dpmcgarry/esp32-marine-sensorhub-v2/hardware/mshv2/mshv2.kicad_sch

## KiCad design hardware/mshv2/mshv2.kicad_sch (2025-12-29, an earlier design)

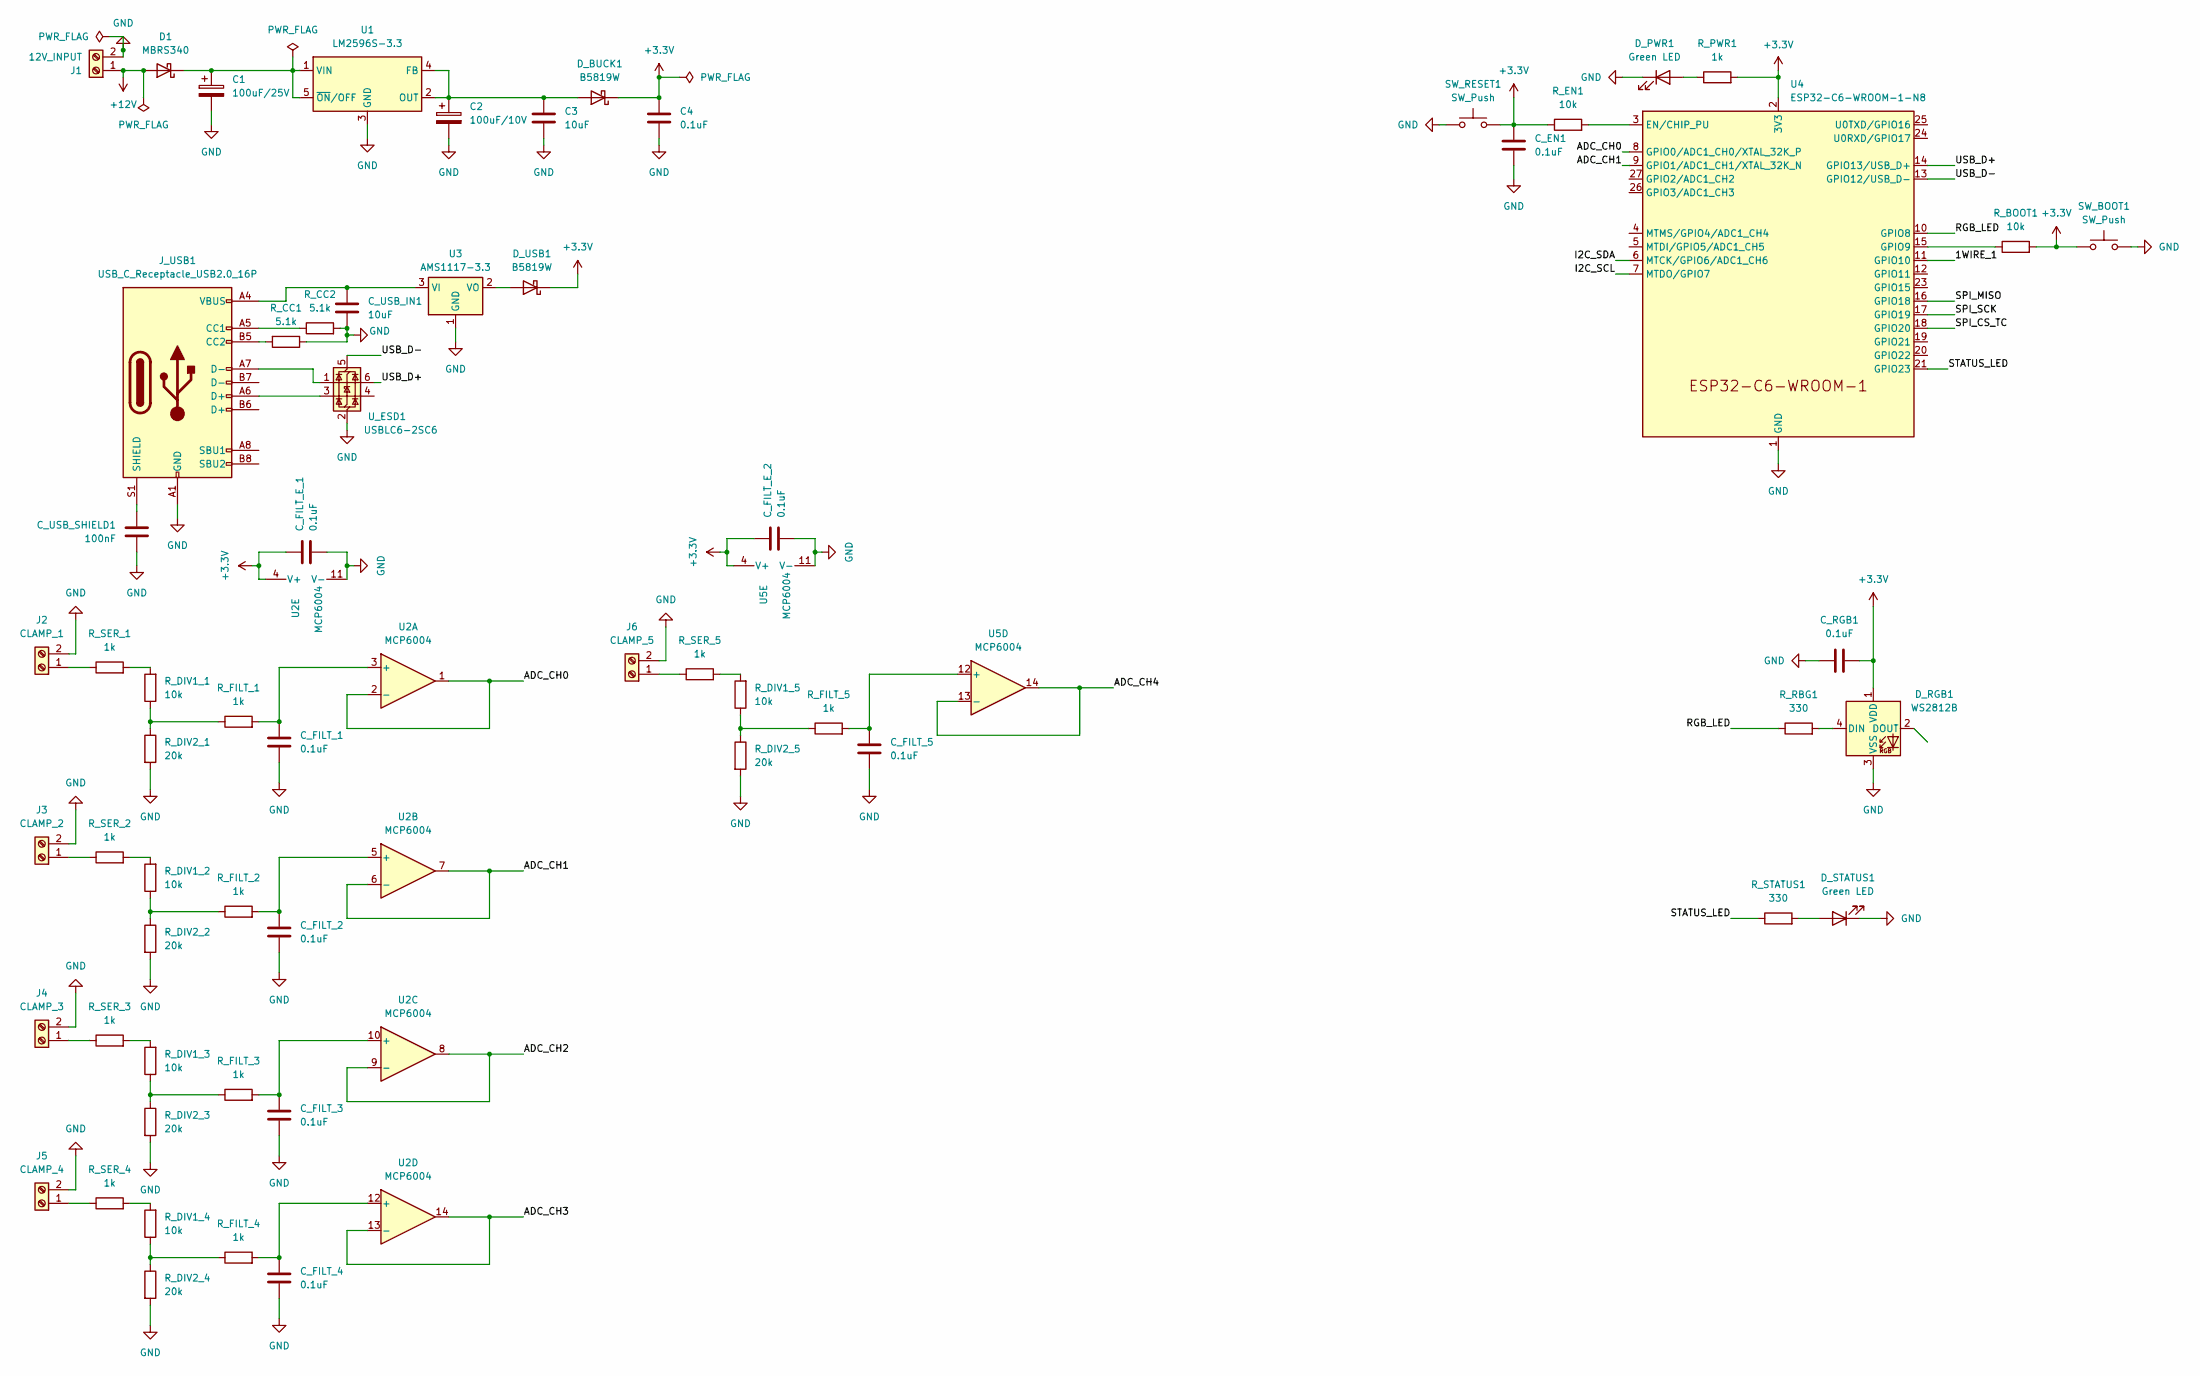
[picture p1: schematic mshv2.kicad_sch]

Parts:
C1: 100uF/25V; C_0201_0603Metric
C2: 100uF/10V; C_0201_0603Metric
C3: 10uF; C_0201_0603Metric
C4: 0.1uF; C_0201_0603Metric
C_EN1: 0.1uF; C_0201_0603Metric
C_FILT_1, C_FILT_2, C_FILT_3, C_FILT_4, C_FILT_5: 0.1uF; C_0201_0603Metric
C_FILT_E_1, C_FILT_E_2: 0.1uF; C_0201_0603Metric
C_RGB1: 0.1uF; C_0201_0603Metric
C_USB_IN1: 10uF; C_0201_0603Metric
C_USB_SHIELD1: 100nF; C_0201_0603Metric
D1: MBRS340; D_SMC
D_BUCK1: B5819W; D_0201_0603Metric
D_PWR1: Green LED; LED_0603_1608Metric
D_RGB1: WS2812B; LED_WS2812B_PLCC4_5.0x5.0mm_P3.2mm
D_STATUS1: Green LED; LED_0603_1608Metric
D_USB1: B5819W; D_0201_0603Metric
J1: 12V_INPUT; TerminalBlock_MaiXu_MX126-5.0-02P_1x02_P5.00mm
J2: CLAMP_1; TerminalBlock_MaiXu_MX126-5.0-02P_1x02_P5.00mm
J3: CLAMP_2; TerminalBlock_MaiXu_MX126-5.0-02P_1x02_P5.00mm
J4: CLAMP_3; TerminalBlock_MaiXu_MX126-5.0-02P_1x02_P5.00mm
J5: CLAMP_4; TerminalBlock_MaiXu_MX126-5.0-02P_1x02_P5.00mm
J6: CLAMP_5; TerminalBlock_MaiXu_MX126-5.0-02P_1x02_P5.00mm
J_USB1: USB_C_Receptacle_USB2.0_16P; USB_C_Receptacle_GCT_USB4105-xx-A_16P_TopMnt_Horizontal
R_BOOT1: 10k; R_0201_0603Metric
R_CC1, R_CC2: 5.1k; R_0201_0603Metric
R_DIV1_1, R_DIV1_2, R_DIV1_3, R_DIV1_4, R_DIV1_5: 10k; R_0201_0603Metric
R_DIV2_1, R_DIV2_2, R_DIV2_3, R_DIV2_4, R_DIV2_5: 20k; R_0201_0603Metric
R_EN1: 10k; R_0201_0603Metric
R_FILT_1, R_FILT_2, R_FILT_3, R_FILT_4, R_FILT_5: 1k; R_0201_0603Metric
R_PWR1: 1k; R_0201_0603Metric
R_RBG1: 330; R_0201_0603Metric
R_SER_1, R_SER_2, R_SER_3, R_SER_4, R_SER_5: 1k; R_0201_0603Metric
R_STATUS1: 330; R_0201_0603Metric
SW_BOOT1: SW_Push; SW_Tactile_Straight_KSA0Axx1LFTR
SW_RESET1: SW_Push; SW_Tactile_Straight_KSA0Axx1LFTR
U1: LM2596S-3.3; TO-263-5_TabPin3
U2, U5: MCP6004; SOIC-14_3.9x8.7mm_P1.27mm
U3: AMS1117-3.3; SOT-223-3_TabPin2
U4: ESP32-C6-WROOM-1-N8; ESP32-C6-WROOM-1
U_ESD1: USBLC6-2SC6; SOT-23-6

Connections:
1WIRE_1: U4.11 (GPIO10)
+3.3V: C4.1, C_EN1.1, C_FILT_E_1.1, C_FILT_E_2.1, C_RGB1.2, D_BUCK1.1 (K), D_RGB1.1 (VDD), D_USB1.1 (K), R_BOOT1.2, R_EN1.1, R_PWR1.2, SW_BOOT1.1, SW_RESET1.2, U2.4 (V+), U4.2 (3V3), U5.4 (V+)
+12V: D1.2 (A), J1.1
ADC_CH0: U2.1, U2.2 (-), U4.8 (GPIO0/ADC1_CH0/XTAL_32K_P)
ADC_CH1: U2.6 (-), U2.7, U4.9 (GPIO1/ADC1_CH1/XTAL_32K_N)
ADC_CH2: U2.8, U2.9 (-)
ADC_CH3: U2.13 (-), U2.14
ADC_CH4: U5.13 (-), U5.14
GND: C1.2, C2.2, C3.2, C4.2, C_EN1.2, C_FILT_1.2, C_FILT_2.2, C_FILT_3.2, C_FILT_4.2, C_FILT_5.2, C_FILT_E_1.2, C_FILT_E_2.2, C_RGB1.1, C_USB_IN1.2, C_USB_SHIELD1.2, D_PWR1.1 (K), D_RGB1.3 (VSS), D_STATUS1.1 (K), J1.2, J2.2, J3.2, J4.2, J5.2, J6.2, J_USB1.A1 (GND), J_USB1.A12 (GND), J_USB1.B1 (GND), J_USB1.B12 (GND), R_CC1.1, R_CC2.2, R_DIV2_1.2, R_DIV2_2.2, R_DIV2_3.2, R_DIV2_4.2, R_DIV2_5.2, SW_BOOT1.2, SW_RESET1.1, U1.3 (GND), U2.11 (V-), U3.1 (GND), U4.1 (GND), U4.28 (GND), U4.29 (GND), U5.11 (V-), U_ESD1.2 (GND)
I2C_SCL: U4.7 (MTDO/GPIO7)
I2C_SDA: U4.6 (MTCK/GPIO6/ADC1_CH6)
unnamed: C1.1, D1.1 (K), U1.1 (VIN), U1.5 (~ON/OFF)
unnamed: C2.1, C3.1, D_BUCK1.2 (A), U1.2 (OUT), U1.4 (FB)
unnamed: C_FILT_1.1, R_FILT_1.2, U2.3 (+)
unnamed: C_FILT_2.1, R_FILT_2.2, U2.5 (+)
unnamed: C_FILT_3.1, R_FILT_3.2, U2.10 (+)
unnamed: C_FILT_4.1, R_FILT_4.2, U2.12 (+)
unnamed: C_FILT_5.1, R_FILT_5.2, U5.12 (+)
unnamed: C_USB_IN1.1, J_USB1.A4 (VBUS), J_USB1.A9 (VBUS), J_USB1.B4 (VBUS), J_USB1.B9 (VBUS), U3.3 (VI)
unnamed: C_USB_SHIELD1.1, J_USB1.S1 (SHIELD)
unnamed: D_PWR1.2 (A), R_PWR1.1
unnamed: D_RGB1.4 (DIN), R_RBG1.2
unnamed: D_STATUS1.2 (A), R_STATUS1.2
unnamed: D_USB1.2 (A), U3.2 (VO)
unnamed: J2.1, R_SER_1.1
unnamed: J3.1, R_SER_2.1
unnamed: J4.1, R_SER_3.1
unnamed: J5.1, R_SER_4.1
unnamed: J6.1, R_SER_5.1
unnamed: J_USB1.A5 (CC1), R_CC2.1
unnamed: J_USB1.A6 (D+), U_ESD1.3 (I/O2)
unnamed: J_USB1.A7 (D-), U_ESD1.1 (I/O1)
unnamed: J_USB1.B5 (CC2), R_CC1.2
unnamed: R_BOOT1.1, U4.15 (GPIO9)
unnamed: R_DIV1_1.1, R_DIV2_1.1, R_FILT_1.1
unnamed: R_DIV1_1.2, R_SER_1.2
unnamed: R_DIV1_2.1, R_DIV2_2.1, R_FILT_2.1
unnamed: R_DIV1_2.2, R_SER_2.2
unnamed: R_DIV1_3.1, R_DIV2_3.1, R_FILT_3.1
unnamed: R_DIV1_3.2, R_SER_3.2
unnamed: R_DIV1_4.1, R_DIV2_4.1, R_FILT_4.1
unnamed: R_DIV1_4.2, R_SER_4.2
unnamed: R_DIV1_5.1, R_DIV2_5.1, R_FILT_5.1
unnamed: R_DIV1_5.2, R_SER_5.2
unnamed: R_EN1.2, U4.3 (EN/CHIP_PU)
RGB_LED: R_RBG1.1, U4.10 (GPIO8)
SPI_CS_TC: U4.18 (GPIO20)
SPI_MISO: U4.16 (GPIO18)
SPI_SCK: U4.17 (GPIO19)
STATUS_LED: R_STATUS1.1, U4.21 (GPIO23)
USB_D+: U4.14 (GPIO13/USB_D+), U_ESD1.6 (I/O1)
USB_D-: U4.13 (GPIO12/USB_D-), U_ESD1.5 (VBUS)
