dpmcgarry/esp32-marine-sensorhub-v2/(commit log)

2025-12-15 Add initial project structure and hardware design documentation
    - Add comprehensive hardware design document (Hardware.md)
    - Add detailed requirements specification (Requirements.md)
    - Add KiCad schematic build guide (KICAD_SCHEMATIC_GUIDE.md)
    - Add project README with overview and features
    - Add Claude instructions document (Claude.md)
    - Initialize KiCad project structure (mshv2/)
    - Add Python schematic generators (experimental)
    - Configure .gitignore for KiCad and Python files
    Key hardware features:
    - ESP32-C6-WROOM-1-N8 (8MB flash) with built-in USB
    - USB-C connector for programming and debugging
    - 6x current clamp inputs (QNHCK2-16) with signal conditioning
    - 3x DS18B20 1-Wire temperatu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
    [mshv2.kicad_pcb, mshv2.kicad_sch]
2025-12-15 Finished part 1
    [mshv2.kicad_sch]
2025-12-15 Part 2 WIP
    [mshv2.kicad_sch]
2025-12-23 docs: Add comprehensive project documentation and dual power design
    - Add complete README.md with project overview, features, and getting started guide
    - Add BREADBOARD_PROTOTYPE.md with phased prototyping strategy and wiring diagrams
    - Update KICAD_SCHEMATIC_GUIDE.md with dual power system (12V + USB-C)
    - Add AMS1117-3.3 LDO regulator for USB power path
    - Add B5819W Schottky OR-ing diodes (D_BUCK and D_USB)
    - Fix USB D+/D- GPIO pin assignments (GPIO12=D-, GPIO13=D+)
    - Fix markdown linting issues across all documentation
    - Wrap long lines to 80 characters
    - Fix table formatting with proper spacing
    - Add blank lines around lists
    - Update Hardware.md and Requirements.md for markdow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
    [mshv2.kicad_sch]
2025-12-27 Fix pin pitch
2025-12-28 feat: Add 3× MAX31855 thermocouple support
    - Expand from 1 to 3 MAX31855 thermocouple amplifiers (U4, U7, U8)
    - Add SPI GPIO assignments for 3 independent CS lines:
    - GPIO20: CS for MAX31855 #1 (U4)
    - GPIO21: CS for MAX31855 #2 (U7)
    - GPIO22: CS for MAX31855 #3 (U8)
    - Update KICAD_SCHEMATIC_GUIDE.md:
    - Add Part 4.5 with complete wiring for all 3 MAX31855 ICs
    - Update GPIO label list with SPI_CS_TC1/TC2/TC3
    - Add thermocouple connector details (J_TC1, J_TC2, J_TC3)
    - Update Hardware.md:
    - Expand MAX31855 section with shared SPI bus architecture
    - Update connector pinout documentation
    - Update BOM: 3× MAX31855 @ $5.00 = $15.00
    - Update capacitors count (13→15, add 2× 0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
2025-12-28 Updating claude directions and WIP on the schematic
    [mshv2.kicad_pcb, mshv2.kicad_sch]
2025-12-28 refactor: Remove redundant J_PROG connector and consolidate terminal blocks
    Remove J_PROG programming header since ESP32-C6 has native USB Serial/JTAG
    on GPIO12/GPIO13 connected to J_USB, eliminating need for external programmer.
    Also consolidate multiple individual 2-pin terminal blocks into multi-position
    connectors for cleaner design.
    **Connector Consolidation:**
    - J_MAIN (11-pin): 12V power + 3× DS18B20 sensors
    - Replaces J_PWR (2-pin) + 3× J_1WIRE (3-pin each)
    - J_TC (6-pin): 3× K-type thermocouples
    - Replaces J_TC1, J_TC2, J_TC3 (2-pin each)
    - J_CLAMP (10-pin): 5× current clamp inputs
    - Replaces J_CLAMP_1 through J_CLAMP_5 (2-pin each)
    **J_PROG Removal Rationale:**
    ESP32-C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
2025-12-28 docs: Standardize on consolidated connector design throughout documentation
    Remove all references to individual connector options (J_PWR, J_TC1-3,
    J_CLAMP_1-5) and consistently document only the consolidated multi-pin
    terminal block approach. This aligns the documentation with the design
    decision to use fewer, larger connectors for improved board layout and
    manufacturing efficiency.
    Changes:
    - KICAD_SCHEMATIC_GUIDE.md: Remove Option A/B language, update all
    connector references to use consolidated J_MAIN, J_TC, and J_CLAMP
    - Hardware.md: Update power supply, DS18B20, thermocouple, and current
    clamp sections to reference consolidated connector pins
    - Requirements.md: Update power section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
2025-12-28 docs: Add hierarchical sheets guide and fix markdown lint issues
    Add comprehensive hierarchical sheet instructions to KiCad schematic guide:
    - Part 0: Setup hierarchical sheets with 7 functional blocks
    - Updated all parts to use sheet-specific hierarchical labels
    - Added navigation instructions between sheets
    - Updated keyboard shortcuts and best practices
    Hierarchical structure:
    - Root Sheet (navigation)
    - Power Supply (12V→3.3V, dual power OR-ing)
    - ESP32 Core (MCU, USB-C, buttons, LEDs)
    - Main Connector (J_MAIN 11-pin breakout)
    - Current Sensing (J_CLAMP + signal conditioning)
    - Temperature Sensors (SHT40 + 1-Wire interface)
    - Thermocouples (J_TC + 3× MAX31855)
    Fix markdown lint issu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
2025-12-28 Part 0 WIP
    [connector_main.kicad_sch, connectors.kicad_sch, esp32.kicad_sch, mshv2.kicad_sch, power.kicad_sch, sensors_current.kicad_sch, sensors_temp.kicad_sch, sensors_termocouple.kicad_sch]
2025-12-28 Fix some issues in the kicad instructions
2025-12-28 feat: Add dashboard I/O interface with piezo buzzer and 12V LED/switch support
    Add comprehensive dashboard I/O interface to support remote panel indicators
    and user controls in marine installations:
    - Add piezo buzzer (GPIO5) with NPN transistor driver for audible alarms
    - Murata PKLCS1212E4001-R1 (SMD) or PKM13EPYH4000-A0 (TH)
    - Software-controllable, always populated
    - 85dB @ 10cm, 4kHz operating frequency
    - Add 3× 12V LED outputs (GPIO11/14/15) with MOSFET drivers
    - 2N7002 N-channel MOSFETs (SOT-23)
    - For panel-mount indicators (red/green/amber suggested)
    - 10kΩ gate resistors for protection
    - Supports long wire runs (10+ feet)
    - Add 3× 12V toggle switch inputs (GPIO16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
2025-12-28 Removing claude's poor attempt at generating a schematic
2025-12-28 docs: Update README with dashboard I/O and implement dual licensing
    Update documentation to reflect recent design changes and implement proper
    open-source licensing for hardware, software, and documentation.
    README.md updates:
    - Add dashboard I/O capabilities to project description
    - Update key features with piezo buzzer, LED outputs, and switch inputs
    - Expand use cases to include dashboard controls and alarms
    - Update project status to reflect starting KiCad schematic from beginning
    - Add "Recent Updates" section documenting breaking changes
    - Update sensors table to include I/O components (piezo, LEDs, switches)
    - Add comprehensive Dashboard I/O Interface section with technical details
    -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
2025-12-29 feat: Implement KiCad schematic Parts 0-3 and update dashboard I/O to 2 LEDs
    KiCad Schematic Implementation:
    - Part 0: Created hierarchical sheet structure (power, ESP32, sensors, I/O)
    - Part 1: Implemented power supply sheet with dual power OR-ing diodes
    - Part 2: Completed ESP32 Core sheet with GPIO assignments and USB-C
    - Part 3: Built current sensing sheet with 5-channel op-amp conditioning
    Documentation Updates (Breaking Change):
    - Reduced dashboard I/O from 3 LEDs to 2 LEDs (GPIO11, GPIO15)
    - Kept 3 switch inputs (GPIO16, GPIO17, GPIO23)
    - GPIO14 not available on ESP32-C6-WROOM-1 module (used internally)
    - Updated Hardware.md, Requirements.md, README.md, KICAD_SCHEMATIC_GUIDE.md
    - J_I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
    [connector_main.kicad_sch, esp32.kicad_sch, mshv2.kicad_sch, power.kicad_sch, sensors_current.kicad_sch, sensors_temp.kicad_sch, sensors_termocouple.kicad_sch]
