dpmcgarry/esp32-marine-sensorhub-v2/(notices)

Notices in the files:
README.md:
Hardware License
https://img.shields.io/badge/software-GPLv3-blue
